wa1hco/Synthesizer-VHF/Hardware/Phase Noise Calculations.ods

Sheet: Regulator noise Plots
Power Supply Noise and Synthesizer Phase noise
Requirement ADF4351 |  | MAX2870 | ADV4350 | ADF4351
Hz | 10 | 1,900 |  |  | nV/sqrt(Hz)
Hz | 100 | 1,100 |  |  | nV/sqrt(Hz)
Hz | 1,000 | 200 |  |  | nV/sqrt(Hz)
Hz | 10,000 | 70 |  | 12,857 | nV/sqrt(Hz)
 | 100,000 |  |  | 30,488 | nV/sqrt(Hz)
 | 1,000,000 |  |  | 96,411 | nV/sqrt(Hz)
 | 5,000,000 |  |  | 215,327 | nV/sqrt(Hz)
Hz | 10,000,000 | 50 |  |  | nV/sqrt(Hz)
MAX8559 MAX2870 Eval | Used in Eval Board
Noise Spectral Density
Hz | 10 | 1,900 | nV/sqrt(Hz)
Hz | 100 | 1,100 | nV/sqrt(Hz)
Hz | 1,000 | 200 | nV/sqrt(Hz)
Hz | 10,000 | 70 | nV/sqrt(Hz)
Hz | 100,000 | 50 | nV/sqrt(Hz)
GM1207
Hz | 1 | 9,000 | nV/sqrt(Hz)
Hz | 10 | 700 | nV/sqrt(Hz)
Hz | 100 | 95 | nV/sqrt(Hz)
Hz | 1,000 | 33 | nV/sqrt(Hz)
Hz | 10,000 | 17 | nV/sqrt(Hz)
Hz | 100,000 | 12 | nV/sqrt(Hz)
Hz | 1,000,000 | 10 | nV/sqrt(Hz)
Hz | 10,000,000 | 2 | nV/sqrt(Hz)
GM1200
Hz | 1 | 10,000 | nV/sqrt(Hz)
Hz | 10 | 700 | nV/sqrt(Hz)
Hz | 100 | 95 | nV/sqrt(Hz)
Hz | 1,000 | 33 | nV/sqrt(Hz)
Hz | 10,000 | 17 | nV/sqrt(Hz)
Hz | 100,000 | 12 | nV/sqrt(Hz)
Hz | 1,000,000 | 10 | nV/sqrt(Hz)
Hz | 10,000,000 | 2 | nV/sqrt(Hz)
TPS7A21
Hz | 1 |  | nV/sqrt(Hz)
Hz | 10 | 800 | nV/sqrt(Hz)
Hz | 100 | 120 | nV/sqrt(Hz)
Hz | 1,000 | 33 | nV/sqrt(Hz)
Hz | 10,000 | 23 | nV/sqrt(Hz)
Hz | 100,000 | 15 | nV/sqrt(Hz)
Hz | 1,000,000 | 15 | nV/sqrt(Hz)
Hz | 10,000,000 | 3 | nV/sqrt(Hz)
TPS7A47
Hz | 1 |  | nV/sqrt(Hz)
Hz | 10 | 500 | nV/sqrt(Hz)
Hz | 100 | 60 | nV/sqrt(Hz)
Hz | 1,000 | 18 | nV/sqrt(Hz)
Hz | 10,000 | 14 | nV/sqrt(Hz)
Hz | 100,000 | 16 | nV/sqrt(Hz)
Hz | 1,000,000 | 10 | nV/sqrt(Hz)
Hz | 10,000,000 |  | nV/sqrt(Hz)
ADP150 ADF4351 Eval | Used in ADF4351 eval board
Hz | 1 |  | nV/sqrt(Hz)
Hz | 10 | 300 | nV/sqrt(Hz)
Hz | 100 | 130 | nV/sqrt(Hz)
Hz | 1,000 | 80 | nV/sqrt(Hz)
Hz | 10,000 | 30 | nV/sqrt(Hz)
Hz | 100,000 | 30 | nV/sqrt(Hz)
Hz | 1,000,000 |  | nV/sqrt(Hz)
Hz | 10,000,000 |  | nV/sqrt(Hz)
LP2992 220 XVTR | Used in 220 transverter
Hz | 1 |  | nV/sqrt(Hz)
Hz | 10 | 3,800 | nV/sqrt(Hz)
Hz | 100 | 1,500 | nV/sqrt(Hz)
Hz | 1,000 | 300 | nV/sqrt(Hz)
Hz | 10,000 | 150 | nV/sqrt(Hz)
Hz | 100,000 | 30 | nV/sqrt(Hz)
Hz | 1,000,000 | 10 | nV/sqrt(Hz)
Hz | 10,000,000 | 10 | nV/sqrt(Hz)
LT3042 Hellmich Sig Gen | https://www.mariohellmich.de/projects/sig-gen/sig-gen.html
Hz | 1 |  | nV/sqrt(Hz)
Hz | 10 | 70 | nV/sqrt(Hz)
Hz | 100 | 10 | nV/sqrt(Hz)
Hz | 1,000 | 24 | nV/sqrt(Hz)
Hz | 10,000 | 20 | nV/sqrt(Hz)
Hz | 100,000 | 25 | nV/sqrt(Hz)
Hz | 1,000,000 | 22 | nV/sqrt(Hz)
Hz | 10,000,000 | 27 | nV/sqrt(Hz)

Sheet: ADF435x Vn requirements
ADF4350
VCO phase noise
Offset | 2.2 GHz | 3.3GHz | 4.4GHz
1000 |  |  |  |  | dBc/Hz
10000 |  |  |  |  | dBc/Hz
100000 |  |  |  |  | dBc/Hz
1000000 |  |  |  |  | dBc/Hz
10000000 |  |  |  |  | dBc/Hz
Frequency Pushing (K0) | 1 | Mhz/V | 1000000 |  | Hz/V
Expression for required power supply noise spectral density (before taking into account all RC filtering at power supply):
https://spok.ca/index.php/resources/articles/93-powersupplynoise
Vn = fm/K0 * sqrt(2 * (10^(dLdb/10) – 1) * L(fm) )
VCO Noise Spec
Vn (uV/sqrt(Hz) |  |  | fm |  | dLdb |  | L(fm)dB 2.2 GHz) | L(fm)dB 3,3 GHz) | L(fm)dB 4,4 GHz) | L(fm) (2.2GHz) | L(fm) (3.3GHz) | L(fm) (4.4GHz) |  |  |  | dL(fm) | dL(fm) = (Vn^2 * K0^2) / (2 * fm^2)
0 | 0 | 0 | 1 |  | 0.1 |  |  |  |  |  |  |  |  |  |  | #REF!
0 | 0 | 0 | 10 |  | 0.1 |  |  |  |  |  |  |  |  |  |  | #REF!
0 | 0 | 0 | 100 |  | 0.1 |  |  |  |  |  |  |  |  |  |  | #REF!
0 | 0 | 0 | 1,000 |  | 0.1 |  |  |  |  |  |  |  |  |  |  | #REF!
13 | 15 | 18 | 10,000 |  | 0.1 |  | -89 | -86 | -83 | 3.55E-05 | 5.01E-05 | 7.08E-05 |  |  |  | #REF!
30 | 36 | 38 | 100,000 |  | 0.1 |  | -114 | -111 | -110 | 2.00E-06 | 2.82E-06 | 3.16E-06 |  |  |  | #REF!
96 | 96 | 108 | 1,000,000 |  | 0.1 |  | -134 | -134 | -132 | 2.00E-07 | 2.00E-07 | 2.51E-07 |  |  |  | #REF!
215 | 256 | 256 | 5,000,000 |  | 0.1 |  | -148 | -145 | -145 | 3.98E-08 | 5.62E-08 | 5.62E-08 |  |  |  | #REF!
0 | 0 | 0 | 10,000,000 |  | 0.1
K0 |  |  | VCO frequency pushing specification
fm |  |  | offset frequency
Vn |  |  | Supply noise voltage spectral density
dLdB |  |  | degradation from phase noise mask (Db)
L(fm) |  |  | VCO phase noise (linear) vs frequency offset
L(fm)dB |  |  | VCO phase noise (dB) vs frequency offset
ADF4351
VCO phase noise
Offset | 2.2 GHz | 3.3GHz | 4.4GHz
1,000 | -52 | -48 | -45 |  | dBc/Hz
10,000 | -89 | -86 | -83 |  | dBc/Hz
100,000 | -114 | -111 | -110 |  | dBc/Hz
1,000,000 | -134 | -134 | -131 |  | dBc/Hz
5,000,000 | -148 | -145 | -145 |  | dBc/Hz
10,000,000 | -151 | -150 | -148 |  | dBc/Hz
Frequency Pushing | 1 | Mhz/V | 1000000 |  | Hz/V
Expression for required power supply noise spectral density (before taking into account all RC filtering at power supply):
https://spok.ca/index.php/resources/articles/93-powersupplynoise
Vn = fm/K0 * sqrt(2 * (10^(dLdb/10) – 1) * L(fm) )
VCO Noise Spec
Vn (nV/sqrt(Hz) |  |  |  |  |  |  | Loop Phase Noise (dBc/Hz) |  |  | SSB VCO Phase Noise (rad/Hz) |  |  | Allowed noise (from book)
2.2 GHz | 3.3 GHz | 4.4 GHz | fm | fm/K0 | dLdb | 2*10^((dLdB/10)-1) | L(fm)dB 2.2 GHz) | L(fm)dB 3,3 GHz) | L(fm)dB 4,4 GHz) | L(fm) (2.2GHz) | L(fm) (3.3GHz) | L(fm) (4.4GHz) | Vn(fm) |  |  | dL(fm) | dL(fm) = (Vn^2 * K0^2) / (2 * fm^2)
0.00E+00 | 0.00E+00 | 0.00E+00 | 1 | 0.000001 | 0.1 | 0.047
0.00E+00 | 0.00E+00 | 0.00E+00 | 10 | 0.000010 | 0.1 | 0.047
0.00E+00 | 0.00E+00 | 0.00E+00 | 100 | 0.000100 | 0.1 | 0.047
1.02E-05 | 1.36E-05 | 1.71E-05 | 1,000 | 0.001000 | 0.1 | 0.047 | -53 | -48 | -44 | 2.24E-03 | 3.98E-03 | 6.31E-03 | 6.69E-05 | 8.92E-03 | 5.23E-03 | 5.21E-05
1.29E-05 | 1.53E-05 | 1.82E-05 | 10,000 | 0.010000 | 0.1 | 0.047 | -89 | -86 | -83 | 3.55E-05 | 5.01E-05 | 7.08E-05 | 8.42E-05 | 1.00E-03 | 5.54E-04 | 8.26E-07
3.05E-05 | 3.62E-05 | 3.84E-05 | 100,000 | 0.100000 | 0.1 | 0.047 | -114 | -111 | -110 | 2.00E-06 | 2.82E-06 | 3.16E-06 | 2.00E-04 | 2.37E-04 | 1.17E-04 | 4.65E-08
9.64E-05 | 9.64E-05 | 1.15E-04 | 1,000,000 | 1.000000 | 0.1 | 0.047 | -134 | -134 | -131 | 2.00E-07 | 2.00E-07 | 2.82E-07 | 6.32E-04 | 6.32E-05 | 3.50E-05 | 4.65E-09
2.15E-04 | 2.56E-04 | 2.56E-04 | 5,000,000 | 5.000000 | 0.1 | 0.047 | -148 | -145 | -145 | 3.98E-08 | 5.62E-08 | 5.62E-08 | 1.41E-03 | 3.35E-05 | 1.56E-05 | 9.27E-10
0.00E+00 | 0.00E+00 | 0.00E+00 | 10,000,000 | 10.000000 | 0.1 | 0.047
K0 |  |  | VCO frequency pushing specification
fm |  |  | offset frequency
Vn |  |  | Supply noise voltage spectral density
dLdB |  |  | degradation from phase noise mask (Db) |  |  |  | 0.0465859845615082
L(fm) |  |  | VCO phase noise (linear) vs frequency offset
L(fm)dB |  |  | VCO phase noise (dB) vs frequency offset

Sheet: MAX2870 Vn requirements
MAX2870
Frequency Pushing | 0.7 | Mhz/V | 700000 | Hz/V
VCO phase noise
Offset | 3000 | 4500 | 6000
10000 | -83.5 | -75 | -71.5 | dBc/Hz
100000 | -111 | -104 | -100.5 | dBc/Hz
1000000 | -136 | -130 | -128 | dBc/Hz
5000000 | -149 | -145.5 | -143.5 | dBc/Hz
Expression for required power supply noise spectral density (before taking into account all RC filtering at power supply):
 | https://spok.ca/index.php/resources/articles/93-powersupplynoise
Variables definition
L(fm) | phase noise of VCO
fm | offset frequency
Vn | phase noise voltage spectral density (V/sqrt(Hz))
dL(fm) | phase noise degradation due to power supply noise density (Vn) at offset (fm)
dL(fm)dB | phase noise degradation in dB, limit, design parameter
Regulator noise requirements from pushing spec
0 | 1 | 0.1 |  |  | 0.00E+00
0 | 10 | 0.1 |  |  | 0.00E+00
0 | 100 | 0.1 |  |  | 0.00E+00
0 | 1,000 | 0.1 |  |  | 0.00E+00
41 | 10,000 | 0.1 | -75 | 1.78E-04 | 4.14E+06
77 | 100,000 | 0.1 | -104 | 6.31E-06 | 1.47E+05
173 | 1,000,000 | 0.1 | -130 | 3.16E-07 | 7.37E+03
355 | 5,000,000 | 0.1 | -145.5 | 5.31E-08 | 1.24E+03
0 | 10,000,000 | 0.1
K0 | VCO frequency pushing specification
fm | offset frequency
Vn | Supply noise voltage spectral density
dLdB | degradation from phase noise mask (Db)
L(fm) | VCO phase noise (linear) vs frequency offset
L(fm)dB | VCO phase noise (dB) vs frequency offset

Sheet: VCO noise
VCO and Frequency Synthesizer Noise (open loop)
VCO Phase Noise |  | Khz | dBc/Hz | 3000 | 4500 | 6000
 | MAX2870 | 10 |  | -83.5 | -75 | -71.5
 |  | 100 |  | -111 | -104 | -100.5
 |  | 1000 |  | -136 | -130 | -128
 |  | 5000 |  | -149 | -145.5 | -143.5
TCXO Phase noise
 | Rakon RPT1490LN | 38.4 | MHz | 37.86 | 41.38 | 43.88
 |  | KHz | dBC/Hz | 3000 | 4500 | 6000
 |  | 0.01 | -92.1 | -54.24 | -50.72 | -48.22
 |  | 0.1 | -125.3 | -87.44 | -83.92 | -81.42
 |  | 1 | -151.3 | -113.44 | -109.92 | -107.42
 |  | 10 | -165.7 | -127.84 | -124.32 | -121.82
 |  | 100 | -175.5 | -137.64 | -134.12 | -131.62
 |  | 1000 | -175.6 | -137.74 | -134.22 | -131.72
 |  | 5000 | -176.9 | -139.04 | -135.52 | -133.02
 | CTS Model 35 | 50 | MHz | 35.56 | 39.08 | 41.58
 |  | KHz | dBC/Hz | 3000 | 4500 | 6000
 |  | 0.01 | -88.7 | -53.14 | -49.62 | -47.12
 |  | 0.1 | -117.1 | -81.54 | -78.02 | -75.52
 |  | 1 | -140.8 | -105.24 | -101.72 | -99.22
 |  | 10 | -153.5 | -117.94 | -114.42 | -111.92
 |  | 100 | -159.2 | -123.64 | -120.12 | -117.62
 |  | 1000 | -160.1 | -124.54 | -121.02 | -118.52
 |  | 5000 | -159.9 | -124.34 | -120.82 | -118.32

Sheet: TCXO noise
 |  |  |  |  |  | SSB Phase Noise (dBc/Hz)
Brand | Model | Tolerance (ppm) | LCSC | MHz | Output | 1 | 10 | 100 | 1000 | 10000 | 100000 | @MHz
HCI | 8122S | 2 | $1.15 | 25 | 3.3V clipped sine |  |  | -115 | -135 | -148 |  | 19.2
HCI | 8122S | 2 | $1.78 | 40 | 1.8V clipped sine |  |  | -115 | -135 | -148 |  | 19.2
HCI | 9132S | 2 | $3.25 | 25 | 2.8V clipped sine |  |  | -115 | -135 | -148 |  | 19.2
JGHC | SMD 3225 | 0.5 | $0.53 | 16.36766 | 0.8 Vpp | -57 | -85 | -110 | -130 | -140 |  | 16.37
YXC | YSO510TP | 2 | $0.70 | 26 | peak shaving sine |  |  | -115 | -135 | -148 |  | 13
Xtalltq | BT0507A/B |  | $7.73 | 12.8 | 0.8 Vpp |  | -95 | -120 | -140 | -145 | -150 | 10
xtaltq | NT0503C | 0.5 | $16.43 | 25 |  |  | -92 | -120 | -140 | -145 | -150 | 10
HCI | VC32H6 | 100 | $5.28 | 100 | 3.3V LVCMOS |  |  |  | -132 | -147 | -152 | 27
YZX | YSV310PR | 25 | $2.28
Skyworks | Si550
