wa1hco/Synthesizer-VHF/hardware/Synthesizer-VHF.kicad_pcb

## KiCad design hardware/Synthesizer-VHF.kicad_pcb (2026-10-27)

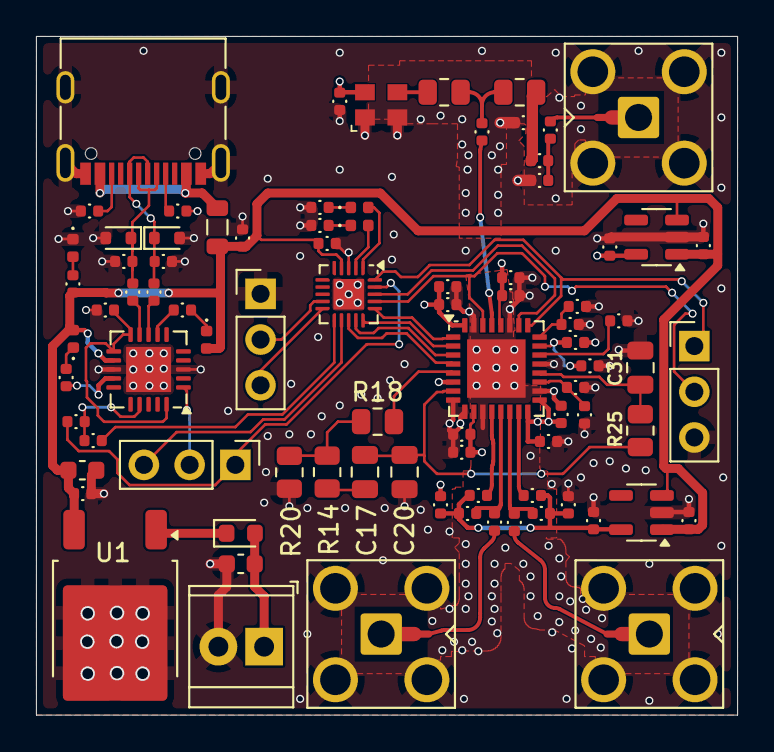
[picture p1: board Synthesizer-VHF.kicad_pcb from above]

Board: 4 copper layers, 38.9 x 37.7 mm, 85 parts (0 on the bottom side), 58 nets.

Parts:
C1: 330n 50V; C_0603_1608Metric
C2, C6, C7, C13, C15, C16, C18, C22, C25, C29, C30, C36, C38: 100n; Cap_0402
C3, C4, C5: 10n; Cap_0402
C8: 6.8u; C_0603_1608Metric
C9, C11: 47p; Cap_0402
C10, C19, C21, C24, C26, C28, C37: 10p; Cap_0402
C12, C23: 100p; Cap_0402
C14, C27, C32, C33: 1u 10V; Cap_0402
C17: 4.7n; C_0805_2012Metric
C20: 2.7n; C_0805_2012Metric
C31: 680p; C_0805_2012Metric
D1: D_Schottky; D_0603_1608Metric
D2, D6: MM3Z3V6; D_SOD-523
D3: blue; LED_0402_1005Metric
D4, D5: Yellow; LED_0402_1005Metric
D7: PA2; LED_0402_1005Metric
D8: PA3; LED_0402_1005Metric
FB1: FerriteBead_Small; L_0805_2012Metric
J1: Screw_Terminal_01x02; TerminalBlock_TE_282834-2_1x02_P2.54mm_Horizontal
J2, J6: Scope; PinHeader_1x03_P2.54mm_Vertical
J4: USB-C 2.0 16P; USB_C_Receptacle_G-Switch_GT-USB-7010ASV
J5: REF_IN; SMA_Amphenol_901-143_Horizontal
J7: RFOUTA; SMA_Amphenol_901-143_Horizontal
J8: Header 1x3; PinHeader_1x03_P2.54mm_Vertical
J9: RFOUTB; SMA_Amphenol_901-143_Horizontal
R1, R3: 5K1; Res_0402
R2, R20: 0R; R_0805_2012Metric
R5, R11, R15, R21, R23: 49R9; Res_0402
R6: 330R; Res_0402
R7: 15R; Res_0402
R8, R9, R10, R12, R16, R17, R19: 1K; Res_0402
R13, R24: 22R; Res_0402
R14: 560R; R_0805_2012Metric
R18, R26: NP; R_0805_2012Metric
R22: 4K7; Res_0402
R25: 1K; R_0805_2012Metric
U1: LM7805A; TO-252-2
U2: FT231XQ; QFN-20-1EP_4x4mm_P0.5mm_EP2.5x2.5mm
U3: ATtiny1616-M; VQFN-20-1EP_3x3mm_P0.4mm_EP1.7x1.7mm
U4: ADF4351; LFCSP-32-1EP_5x5mm_P0.5mm_EP3.25x3.25mm
U7, U8: ADP150AUJZ-3.3-R7; SOT-23-5
X1: HCI 8122S-25NQ33FTL; Oscillator_SMD2520

Connections:
/3V3: C7.1, U2.10 (3V3OUT), U2.11 (~RESET), U2.20 (VCCIO)
/5V: C2.1, C6.1, C8.1, C29.1, C32.1, C33.1, D4.2 (A), D5.2 (A), FB1.2, R9.2, U1.3 (VO), U2.12 (VCC), U3.4 (VCC), U7.1 (VIN), U7.3 (EN), U8.1 (VIN), U8.3 (EN)
/12V: C1.1, D1.2 (A), J1.1
/CE: U3.13 (PB1), U4.4 (CE)
/CLK: U3.16 (PC1), U4.1 (CLK)
/D+M: R13.1, U2.8 (USBDP)
/D-M: R24.1, U2.9 (USBDM)
/DATA: U3.15 (PC0), U4.2 (DATA)
/LD: J2.1, U3.20 (PA1), U4.25 (LD)
/LE: U3.14 (PB0), U4.3 (LE)
/MUX: J2.2, U3.17 (PC2), U4.30 (MUXOUT)
/RF_EN: U3.18 (PC3), U4.26 (PDB_RF)
/RXD_M: R16.2, U3.11 (PB3)
/RXD_U: J8.2, U2.1 (RXD)
/RXLED/: R8.1, U2.14 (CBUS1)
/TXD_M: J8.3, U3.12 (PB2)
/TXD_U: R12.1, R16.1, U2.17 (TXD)
/TXLED/: R19.1, U2.7 (CBUS2)
/UPDI: J8.1, R12.2, U3.19 (~RESET/PA0)
/VCC_1: C5.2, C13.1, C18.1, C19.2, C21.2, C24.1, C25.1, C27.1, C28.2, C30.1, U4.6 (Vp), U4.10 (AVDD), U4.16 (VVCO), U4.17 (VVCO), U4.28 (DVDD), U4.32 (SDVDD), U7.5 (VOUT), X1.4 (V+)
/VCC_2: C14.1, C15.1, C22.1, R11.2, R15.2, R21.2, R23.2, U8.5 (VOUT)
/Vtune: C31.1, R25.2, U4.20 (VTUNE)
GND: C1.2, C2.2, C5.1, C6.2, C7.2, C8.2, C9.2, C10.2, C11.2, C13.2, C14.2, C15.2, C16.1, C18.2, C19.1, C20.2, C21.1, C22.2, C24.2, C25.2, C26.2, C27.2, C28.1, C29.2, C30.2, C31.2, C32.2, C33.2, C36.2, C37.1, C38.2, D2.2 (A), D3.1 (K), D6.2 (A), J1.2, J2.3, J4.A1 (GND), J4.A12 (GND), J4.B1 (GND), J4.B12 (GND), J4.S1 (SHIELD), J5.2 (Ext), J6.1, J7.2 (Ext), J9.2 (Ext), R1.1, R3.1, R5.2, R6.2, R10.2, R17.2, R20.2, R22.1, U1.2 (GND), U2.3 (GND), U2.13 (GND), U2.21 (GND), U3.3 (GND), U3.21 (GND), U4.8 (CPGND), U4.9 (AGND), U4.11 (AGNDVCO), U4.18 (AGNDVCO), U4.21 (AGNDVCO), U4.27 (DGND), U4.31 (SDGND), U4.33 (EP), U7.2 (GND), U8.2 (GND), X1.1 (E/B), X1.2 (GND)
unnamed: C3.2, R2.2, R26.1
unnamed: C4.1, R5.1, R7.1
unnamed: C17.2, R14.1
unnamed: D1.1 (K), U1.1 (VI)
unnamed: C9.1, D2.1 (K), J4.A7 (D-), J4.B7 (D-), R24.2
unnamed: D3.2 (A), R9.1
unnamed: D4.1 (K), R8.2
unnamed: D5.1 (K), R19.2
unnamed: C11.1, D6.1 (K), J4.A6 (D+), J4.B6 (D+), R13.2
unnamed: D7.2 (A), U3.1 (PA2)
unnamed: D7.1 (K), R10.1
unnamed: D8.2 (A), U3.2 (PA3)
unnamed: D8.1 (K), R17.1
unnamed: FB1.1, J4.A4 (VBUS), J4.A9 (VBUS), J4.B4 (VBUS), J4.B9 (VBUS)
unnamed: J4.A5 (CC1), R3.2
unnamed: J4.B5 (CC2), R1.2
unnamed: C4.2, J5.1 (In)
unnamed: J6.2, U3.9 (PB5)
unnamed: J6.3, U3.10 (PB4)
unnamed: C12.2, J7.1 (In)
unnamed: C23.2, J9.1 (In)
unnamed: R14.2, R18.1, R20.1
unnamed: R6.1, R7.2, R26.2
unnamed: C17.1, C20.1, R25.1, U4.7 (CPout)
unnamed: C3.1, U4.29 (REFIN)
unnamed: R21.1, U4.12 (RF_OUT_A+)
unnamed: C12.1, R23.1, U4.13 (RF_OUT_A-)
unnamed: C23.1, R11.1, U4.14 (RF_OUT_B+)
unnamed: R15.1, U4.15 (RF_OUT_B-)
unnamed: R22.2, U4.22 (RSET)
unnamed: R18.2, U4.5 (SW)
unnamed: C16.2, C37.2, U4.19 (TEMP)
unnamed: C26.1, C38.1, U4.23 (VCOM)
unnamed: C10.1, C36.1, U4.24 (VREF)
unnamed: R2.1, X1.3 (OUT)
