wa1hco/Synthesizer-VHF/software/src/UserInterface.cpp

// SPDX-License-Identifier: GPL-3.0-or-later
// User Interface
// Called from loop()
// user enters a line of characters terminated by \r
// each command is expected to be complete on one line
// build line character array
// line contain command and variable number of tokens
// Extract the command token, first token from line
// Set next state based on command first character {s, k, r, c, t, d}

// adf4351 software review
//  disable, enable
//  gcd_iter
//  getReg
//  init
//  setf
//  setrf
//  writeDev
//  BandSelClock
//  cfreq, calculated frequency
//  ChanStep, 
//  ClkDiv, related to phase resync and fast lock
//  enabled, stores current freq and on/off
//  Frac, overwritten by setf
//  Mod, overwritten by setf
//  N_Int, stores PLL_INIT value
//  ourdiv, overwritten by setf
//  PFDfreq, changed if new ref freq used
//  Prescaler, flag 0/1
//  pwrlevel, 0-4
//  R[6], register array
//  RCounter, divider for ref
//  RD1Rdiv2, divide by 2 between Rcounter and PFD
//  reffreq
//  spi_settings

// register and related functions
//   assemble variables into register bit fields
//   save registers in eeprom
//   restore registers from eeprom
//   save variables in eeprom
//   restore variables from eeprom
//   extract variables from register values
// Choices
//   1) save only assembled registers, add extract function
//   2) save only register bit field variables, Config.N Config.refclk, etc.

#include <SerialReadLine.h>
#include <stdlib.h>
#include <errno.h>
#include <EEPROM.h>
#include <CRC.h>

#include "UserInterface.h"
#include "HardwareConfig.h"
#include "SoftwareConfig.h"

#define LINELEN 40
char Line[LINELEN + 1];   // Line of user text needs to be available to multiple functions

// parse functions, return false on error, true on Config change
bool InitCmd(char * Token);

// other commands
bool BootCmd();
void UpdateConfig();        // write Config when parse function true
void FlushLines();
void PrintHelp();           // flush anything in the input buffer

#define OPEN   LOW    // map Digital pin to Sequencer contact closure 
#define CLOSED HIGH
#define MAX_TOKENS_PER_LINE 4
static char * Tokens[MAX_TOKENS_PER_LINE];
static bool needCmdPrompt = true;

/**
* Stein's Algorithm .
* @author Andrei Ciobanu
* @date DEC 12, 2010
* https://github.com/nomemory/blog-stein-algorithm-c/blob/main/b_gcd_iterative.c
*/

uint32_t b_gcd(uint32_t num1, uint32_t num2)
{
	uint32_t pof2, tmp;
	if (!num1 || !num2) {
		return (num1 | num2);
	}

	// pof2 is the greatest power of 2 deviding both numbers .
	// We will use pof2 to multiply the returning number .
	pof2 = 0;
	while(!(num1 & 1) && !(num2 & 1)) {
		// gcd(even1, even1) = pof2 * gcd(even1/pof2, even2/pof2)
		num1 >>=1;
		num2 >>=1;
		pof2++;
	}

	do {
		while (!(num1 & 1)) {
			num1 >>=1;
		}
		while (!(num2 & 1)) {
			num2 >>=1;
		}
		// At this point we know for sure that
		// num1 and num2 are odd
		if (num1 >= num2) {
			num1 = (num1 - num2) >> 1;
		}
		else {
			tmp = num1;
			num1 = (num2 - num1) >> 1;
			num2 = tmp;
		}
	} while (!(num1 == num2 || num1 == 0));

	return (num2 << pof2);
}

void printBinary(byte value) {
  for (int i = 7; i >= 0; i--) {
    Serial.print(bitRead(value, i)); // Reads and prints each bit
  }
}

// pretty print synthesizer configuration on serial port
void PrintConfig() {
  Serial.println("ADF4351 Synthesizer, (c) wa1hco, V0.1, Creative Commons");
  for(int ii = 0; ii < 6; ii++) {  // for each register
    byte b;
    Serial.print("Reg "); 
    Serial.print(ii);
    Serial.print(" ");
    b = (uint8_t) (reg[ii] >> 24); printBinary(b); Serial.print(" "); Serial.printHex(b); Serial.print(" ");
    b = (uint8_t) (reg[ii] >> 16); printBinary(b); Serial.print(" "); Serial.printHex(b); Serial.print(" ");
    b = (uint8_t) (reg[ii] >>  8); printBinary(b); Serial.print(" "); Serial.printHex(b); Serial.print(" ");
    b = (uint8_t) (reg[ii]      ); printBinary(b); Serial.print(" "); Serial.printHex(b); Serial.print(" ");
    Serial.println();
  } 
  snprintf(Msg, 120, "      Fout %lu, Fpfd %lu", Fout, Fpfd);            Serial.println(Msg);
  snprintf(Msg, 120, "Reg 0 INT       %d, FRAC   %d",  INT, FRAC);       Serial.println(Msg);
  snprintf(Msg, 120, "Reg 1 prescaler %d, MOD    %d",  prescaler, MOD);  Serial.println(Msg);
  snprintf(Msg, 120, "Reg 2 nm        %d, muxout %d, ref*2   %d, ref/2        %d, R       %d, cpc %d, ldf %d, ldp %d", 
                           noise_mode, muxout, ref_doubler, ref_by_2, r_counter, charge_pump_current, ldf, ldp); Serial.println(Msg);
  snprintf(Msg, 120, "Reg 3 bs_mode   %d, abp    %d, chg_cancel %d, clk_div %d",
                           band_sel_clk_mode, abp, chg_cancel, clock_divider); Serial.println(Msg);
  snprintf(Msg, 120, "Reg 4 rf_dev    %d, band_sel_div %d, mute_ld %d, aux %d, rf %d", 
                           1<<rf_div_sel, band_select_clkdiv, mute_till_ld, aux_out_ena, rf_out_ena); Serial.println(Msg);
  snprintf(Msg, 120, "Reg 5 ld_pinmode %d", ld_pinmode); Serial.println(Msg);

  // DEBUG
  Serial.print("CRC ");
  Serial.print(Config.CRC16, HEX);
  Serial.println();

} // PrintConfig()


void UserConfig() {
  static char * Token;
  uint8_t TokenCnt;
  static bool isConfUpdate = false;

  // these variable get passed from state call to state call
  static uint8_t StepIdx;  // step command index number, {0 to 3}
  static char    StepArg;  // step command argument {Tx, Rx, Open, Closed}
  static char    CmdChar;  // used for token processing

  if (needCmdPrompt) {
    Serial.println("UserConfig: ");
    PrintConfig();
    FlushLines();
    needCmdPrompt = false;
    snprintf(Msg, 80, "%s", "Command list: freq, rf, aux, ...");
    Serial.println(Msg);
  }

  reader.poll();  // update the serial reader status
  if(!reader.available()) { // wait for user to enter a line
    needCmdPrompt = false;
    return;
  }

  if (reader.len() > LINELEN) {
    FlushLines();
    return;
  }
  reader.read(Line);
  if (strlen(Line) == 0) {
    return;
  }

  // try to read all the tokens that might be on line
  // no need to check for Token = NULL at this point
  snprintf(Msg, 80, "User line '%s' len %d, ", Line, strlen(Line));
  Serial.print(Msg);

  Tokens[0] = strtok(Line, " "); // first Token is handled differently
  for(TokenCnt = 1; TokenCnt < MAX_TOKENS_PER_LINE; TokenCnt++) {
    Token = strtok(NULL, " ");
    Tokens[TokenCnt] = Token;
  } 

  Serial.print("Tokens ");
  for (TokenCnt = 0; TokenCnt < MAX_TOKENS_PER_LINE; TokenCnt++) {
    Serial.print("'");
    Serial.print(Tokens[TokenCnt]);
    Serial.print("' ");
  }
  Serial.println();

  if (strcmp(Tokens[0], "freq") == 0) {
    Fout = FreqCmd();
    // set variables from frequency
    uint32_t GCD = b_gcd(Fout, Fref);
    snprintf(Msg, 80, "FreqCmd: freq %ul, ref %ul, GCD %ul", Fout, Fref, GCD);
  }
  else if (strcmp(Tokens[0], "ref") == 0) {
    Serial.println("UserConfig: ref cmd");
    // refCmd()) UpdateConfig();
  }
  else if (strcmp(Tokens[0], "rf") == 0) {
    Serial.println("UserConfig: rf cmd");
  }  
  else if (strcmp(Tokens[0], "aux") == 0) {
    Serial.println("UserConfig: aux cmd");
  }
  else if (strcmp(Tokens[0], "Init") == 0) {
    if (InitCmd(Tokens[0])) UpdateConfig;    // require whole token
  }
  else if (strcmp(Tokens[0], "Boot") == 0) {
    BootCmd();
  }
  else if (strcmp(Tokens[0], "help") == 0) {
    PrintHelp();
  }
  else {
    snprintf(Msg, 80, "invalid command, Token '%s', hex %x %x %x, len %d", Token, Token[0], Token[1], Token[2], strlen(Token));
    Serial.println(Msg);
  }
} // UserConfig() 

// called when line available starting with Tokens[0] is freq command
// Get Fout
uint32_t FreqCmd() {
  char * endptr;
  char * Token;

  Token = Tokens[1];
  if (Token == NULL) {
    Serial.println("Token NULL, incomplete command");
    return false;
  }
  // get the Fout, first check errors
  uint32_t ulFreq = strtoul(Token, &endptr, 10);
  if (errno == ERANGE) {
    Serial.println("FreqCmd: strtol() ERANGE");
    return false;
  } 
  if (endptr == Token) {
    Serial.println("FreqCmd: (endptr == Token), no conversion");
    return false;
  }
  if (*endptr != '\0') {
    snprintf(Msg, 80, "FreqCmd: Token %x, '%s', endptr %x, '%s', ", Token, endptr, endptr);
    Serial.println(Msg);
    return false;
  } 
  return ulFreq;
}

// get msec Tx or Rx delay msec, 0 to 255
int Get_msec(char * Token) {  
  char * endptr;
  if (Token == NULL) {
    Serial.println("msec: missing delay value ");
    return -1;
  } 
  // Token available, check msec
  long lmsec = strtol(Token, &endptr, 10); 
  if (endptr == Token) {
    Serial.print("msec: strtol(msec) failed");
    return -1;
  } 
  if ((lmsec < 0) | (lmsec > 255)) {
    Serial.println("msec: out of range");
    return -1;
  }
  return (int) lmsec;
} // Get_msec()

// wait for enable or disable
bool RTScmd() {
  char * Token = Tokens[1];
  if (Token == NULL) {  // check mission command argument
    Serial.println("rts: incomplete command");
    return false;
  } 
  // Token not NULL
  char ArgChar = (tolower(Token[0])); // on first character...
  if (ArgChar == 'e') {
  //  Config.RTSEnable = true;
    return true;
  }
  if (ArgChar == 'd') {
  //  Config.RTSEnable = false;
    return true;
  }
  return false; // didn't find 'd' or 'e' argument  
}

bool CTScmd() {
  char * Token = Tokens[1];
  if (Token == NULL) {  // check mission command argument
    Serial.println("cts: incomplete command");
    return false;
  } 
  // Token not NULL
  char ArgChar = (tolower(Token[0]));  // on first character...
  if (ArgChar == 'e') {
  //  Config.RTSEnable = true;
    return true;
  }
  if (ArgChar == 'd') {
  //  Config.RTSEnable = false;
    return true;
  }
  return false;  
}

bool BootCmd() {
  if (strcmp(Tokens[0], "Boot") == 0) { // require whole token
    _PROTECTED_WRITE(RSTCTRL.SWRR,1); // magic boot command
    Serial.println("reboot failed");
    return false;
  } else {
    Serial.println("UserInterface: 'Boot' type full command, case sensitive");
    return false;
  }
}  

// flush the user input, used at startup and after input error
void FlushLines() {
  while (reader.available()) {
    char Line[reader.len()];
    reader.read(Line);
    snprintf(Msg, 80, "FlushLines: Line %s, Len %d", Line, strlen(Line));
    Serial.println(Msg);
  }
} // FlushLines()

// The user may have made changes to the config
void UpdateConfig() {
    Config.CRC16 = CalcCRC(Config);  // update CRC16
    PutConfig(0, Config);  // write changed bytes of config to EEPROM
//
    needCmdPrompt = true;
} // UpdateConfig()

bool InitCmd(char * Token) {
  // initialize config from EEPROM
  if (strcmp(Token, "Init")== 0) { // require whole token
    Config = InitDefaultConfig();
    return true;
  }  
  Serial.print("UserInterface: 'Init' command entry error -");
  Serial.print(Token);
  Serial.println("-");
  return false;
}

void PrintHelp() {
  Serial.println("This is help for the user interface.");
  Serial.println("The user enters command and parameters, MCU echos after end of line");
  Serial.println("Input is one line at a time");
  Serial.println("Entry is case insensitive, with two exceptions");
  Serial.println("Top level configuration commands: S(tep), R(TS), C(TS), T(imeout)"); 
  Serial.println("Top level Info commands: D(isplay), Boot, Init, H(elp)");
  Serial.println("  Display, print working configuration");
  Serial.println("  Init, spelled out, initialize configuration to programmed defaults");
  Serial.println("  Boot, spelled out, simulates power cycle");
  Serial.println("  Help, print this text");
  Serial.println("Changes are automatically written to EEPROM");
  Serial.println("Examples...");
  Serial.println("  'd', display configuration");
  Serial.println("  'Init', case sensitive, spelled out, initialize to programmed defaults");
  Serial.println("  'Boot', case Sensitive, spelled out, reboot using software reset");
} // PrintHelp
