wa1hco/Synthesizer-VHF/(commit log)

2024-12-20 Schematic and layout of ADF4350 synthesizer with dual outputs, ATTiny1616, USB serial, and 12V input
    [ADF4350.kicad_pcb, ADF4350.kicad_sch, MAX2870_EVKIT.kicad_pcb, MAX2870_EVKIT.kicad_sch, Phase Noise Calculations.ods, Synthesizer-VHF.kicad_pcb, Synthesizer-VHF.kicad_sch]
2024-12-20 Added test points for scope probes, tweaked layout a bit
    [Synthesizer-VHF.kicad_pcb, Synthesizer-VHF.kicad_sch]
2024-12-20 Tried to find a better TCXO at 40 MHz, but jlcpcb froze all of kicad several times.
    [Synthesizer-VHF.kicad_pcb, Synthesizer-VHF.kicad_sch]
2025-01-04 Complete design used for pricing experient. 0.2 mm drilled vias cost a lot. had assembling through hole adds a lot 4 layers is is free Next up, climb the learning curve on 4 layer design price compon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
    [Synthesizer-VHF.kicad_pcb]
2025-01-08 Final version for costing and possible ordering Change TCXO to on available from LCSC
    [Phase Noise Calculations.ods, Synthesizer-VHF.kicad_pcb, Synthesizer-VHF.kicad_sch]
2025-01-14 This what got sent to fab. The wiring for SPI between MCU and ADF4351 is not connected to the hardware SPI pins and will need bit banging.
    [Synthesizer-VHF.kicad_pcb, Synthesizer-VHF.kicad_sch]
2025-01-23 cleanup deleted files
    [ADF4350.kicad_pcb, ADF4350.kicad_sch, MAX2870_EVKIT.kicad_pcb, MAX2870_EVKIT.kicad_sch]
2025-02-03 Adding userinterface for configuring synth
    [Synthesizer-VHF.kicad_pcb]
2025-02-09 work on user interface, gcd algorithm to find best Fpfd for integer N. Farey rational number search to find best MOD and FRAC for fractional N
    [Fractional N calculations.ods, adf config design.txt]
2025-02-15 added rational number approximation to find FRAC/MOD for fractional N mode added greatest common divisor calculation to fine best combiation of N and R for integer N mode added printout of named regi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
    [Fractional N calculations.ods, adf config design.txt]
2026-10-26 Move the board and firmware into hardware/ and software/
    Keep history with renames from dev, which already contains the fab
    board plus the ATtiny1616 firmware. Restore the project symbol library
    the schematic still uses, drop duplicate datasheets and leftover files,
    and fix the ADF4350 symbol library path.
2026-10-26 Vendor the project KiCad libraries under hardware/libraries
    Point the symbol and footprint tables at ${KIPRJMOD} and drop the
    unused MAX2870 entry. The schematic and board stay in the KiCad 8
    file format, which KiCad 10 opens without a conversion.
2026-10-26 Record JLCPCB's default 7628 4-layer stackup
    The board is ordered as the default 1.6 mm 4-layer stack, not 3313.
    Outer prepreg is 7628, 0.2104 mm, Er 4.4; the core is 1.065 mm, Er 4.6.
    Solder mask is 1.2 mil at Er 3.8. Saving from KiCad 10.0.7 rewrites the
    board into the KiCad 10 file format. Copper geometry is unchanged.
2026-10-26 Route the RF nets as 50 ohm coplanar waveguide
    RF_50 is a 0.22 mm trace with a 0.20 mm gap on F.Cu over the In1 ground plane, sized for JLCPCB's default 7628 stackup and solder mask. Stitching vias and tapered SMA launches follow the runs. The board file is KiCad 10 format.
2026-10-26 Rebuild the RF routes on the board that was sent to fab
    The PCB had picked up layout edits from d573a80 after the fab
    commit. Restore that copper, keep the 7628 stackup and RF_50 rules,
    and route the coplanar waveguide on the fabricated geometry.
2026-10-26 Move the board dimensions off copper onto User.Drawings
    Six aligned dimensions, and the text on each, were drawn on F.Cu.
    KiCad stores that user layer as Dwgs.User. No other geometry changed.
2026-10-27 Curve the RF_50 corners into arc segments
    Twenty-two corners on the 0.22 mm coplanar traces become KiCad arcs.
    The radius is 0.70 mm where the trace has room, and smaller only where
    a short segment or a pad split forces it. SMA tapers stay straight, and
    the ground corridors follow the arcs at the same 0.20 mm gap.
2026-10-27 Tighten full-pour clearance to 0.25 mm
    The F.Cu, B.Cu, and In1 GND pours and the In2 /VCC_1 plane now fill
    at 0.25 mm instead of 0.50 mm. The RF corridor zones stay at 0.20 mm,
    and the thermal relief and 0.33 mm track-to-PTH rule are unchanged.
    Remove the HTML page that was saved as JLCPCB.kicad_dru.
2026-10-27 Stitch one floating GND island and keep out two slivers
    A 0.45/0.3 mm GND via at (163.177, 100.862) ties the F.Cu island
    to the plane. The RF_GCPW_N triangle and RF_GCPW_S fragment are
    too narrow for that via, so F.Cu pour keepouts remove them.
2026-10-29 Fix ADF4351 frequency math so R0–R5 produce the requested Fout (#7)
    * Fix ADF4351 tuning so the written registers hit the requested frequency.
    The R divider and PFD were computed into locals and never reached Register 2,
    and the fractional remainder was truncated to 16 bits. Tune from the VCO
    with fundamental feedback, and check the packed R0-R5 words on the host.
    * Set the power-on frequency to 144.170 MHz.
    Both the register-field default and the EEPROM default config were 50.2 MHz.
    ---------
    Co-autho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
